sSergey8/eps-controller/README.md

# EPS Controller

Контроллер на Arduino Nano для работы с электроусилителем руля **Nissan Qashqai**. Преобразует импульсный сигнал датчика скорости автомобиля в CAN-сообщения для штатного блока ЭУР.

В проекте используются Arduino Nano на ATmega328P и CAN-модуль MCP2515 с кварцем 8 МГц. Предусмотрены настройка параметров и калибровка скорости через сервисный режим.

## Содержимое проекта

| Раздел | Что находится внутри |
|---|---|
| [sketch](sketch/) | Скетч Arduino и описание его работы |
| [Schematic](Schematic/) | Принципиальная схема, общий вид подключения блоков и распиновка разъёмов ЭУР |
| [Calibration](Calibration/) | Инструкция по сервисному режиму, настройке и калибровке в форматах README и PDF |

Начать знакомство с подключением устройства можно с раздела [Schematic](Schematic/), а подготовку к настройке — с раздела [Calibration](Calibration/).
