sSergey8/eps-controller/Schematic/README.md

# Схема подключения EPS Controller

Контроллер состоит из Arduino Nano, входного тракта сигнала скорости, CAN-модуля MCP2515 с кварцем 8 МГц и CAN-трансивером, а также преобразователя питания 12 → 5 В. Соединения и обозначения выводов приведены на схеме.

## Питание контроллера

На вход преобразователя подаётся **+12 В** автомобильной сети. Его выход **+5 В** питает Arduino Nano, CAN-модуль и входной тракт. Все точки **GND** объединяются с общим проводом автомобиля.

## Подключение электроусилителя

Выходы **CAN H** и **CAN L** модуля подключаются к соответствующим линиям блока ЭУР Nissan Qashqai. Для соединения используется витая пара.

**Силовое питание ЭУР подключается отдельно от контроллера.** Силовые провода идут на прямую к **+12 (через предохранитель)** и **-**.

На разъёме ЭУР также предусмотрен отдельный **контакт разрешения работы**. На него необходимо подавать **+12 В при включённом зажигании**. Этот управляющий контакт не заменяет силовое питание блока.

Номера контактов разъёма необходимо сверять с распиновкой конкретного блока ЭУР.
