sSergey8/eps-controller/Schematic/eps-connector-pinout.png

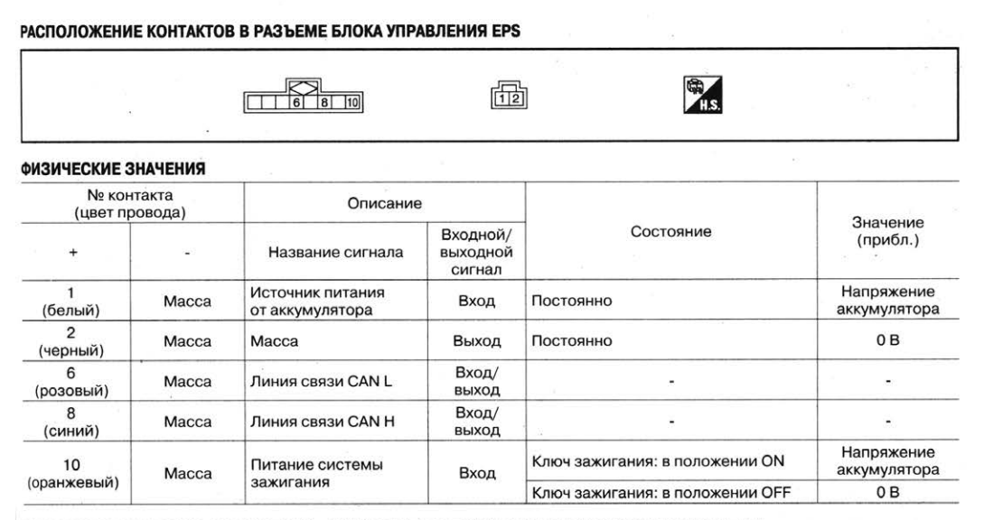
Schematic/eps-connector-pinout.png
