sSergey8/eps-controller/Schematic/eps-controller-schematic.png

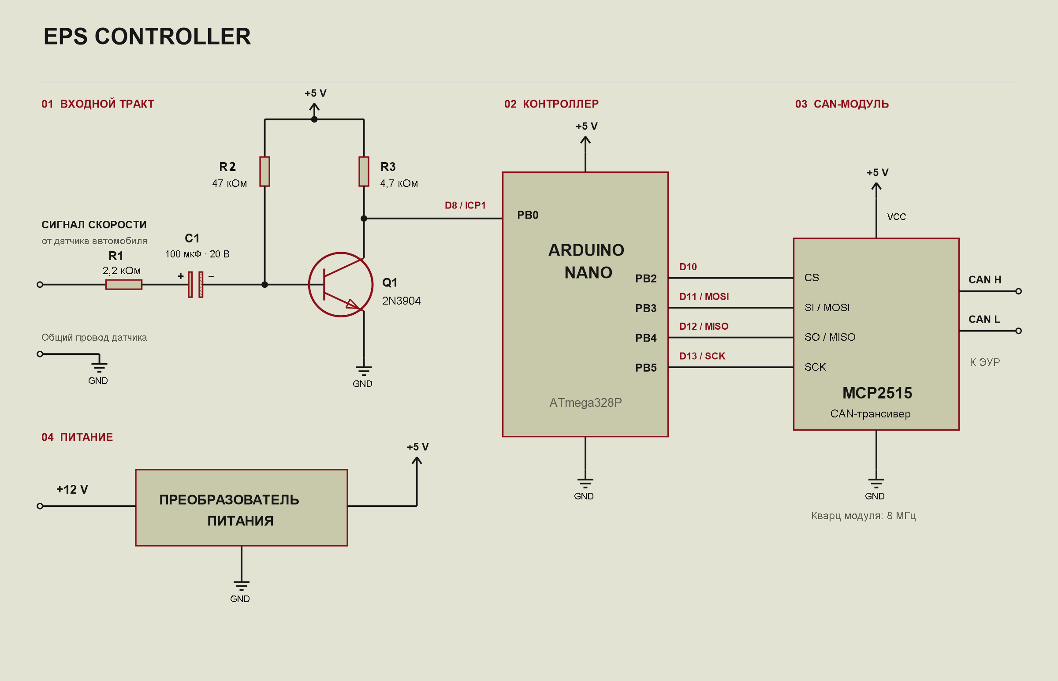
Schematic/eps-controller-schematic.png
