sSergey8/eps-controller/Schematic/eps-controller-wiring-overview-v2.png

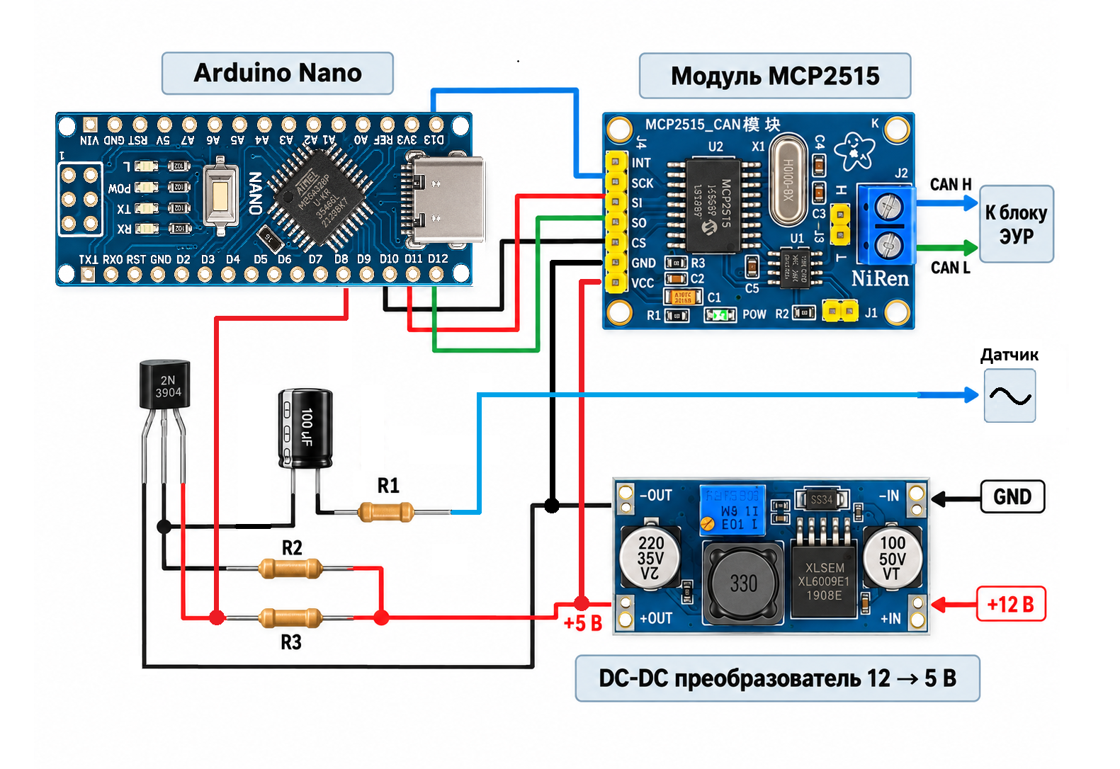
Schematic/eps-controller-wiring-overview-v2.png
