sSergey8/eps-controller/(commit log)

2026-10-30 Добавлено описание папки со скетчем Arduino
2026-10-30 Добавлен скетч Arduino OCR1A_ICP1_8
2026-10-30 Добавлено описание скетча для ЭУР Nissan Qashqai
2026-10-30 Описание скетча
2026-10-30 Скетч Arduino
2026-10-30 Структура Hardware
2026-10-30 Описание схемы
2026-10-30 Принципиальная схема
2026-10-30 Распиновка разъема ЭУР
2026-10-31 Фото к схеме
2026-10-31 Общий вид подключения блоков
2026-10-31 Схемы в папке Schematic
2026-10-31 Сервисный режим и калибровка
2026-10-31 Описание проекта
2026-11-01 Общий вид подключения блоков v2
